prosper00/arpeggiator/20201117_184952.jpg

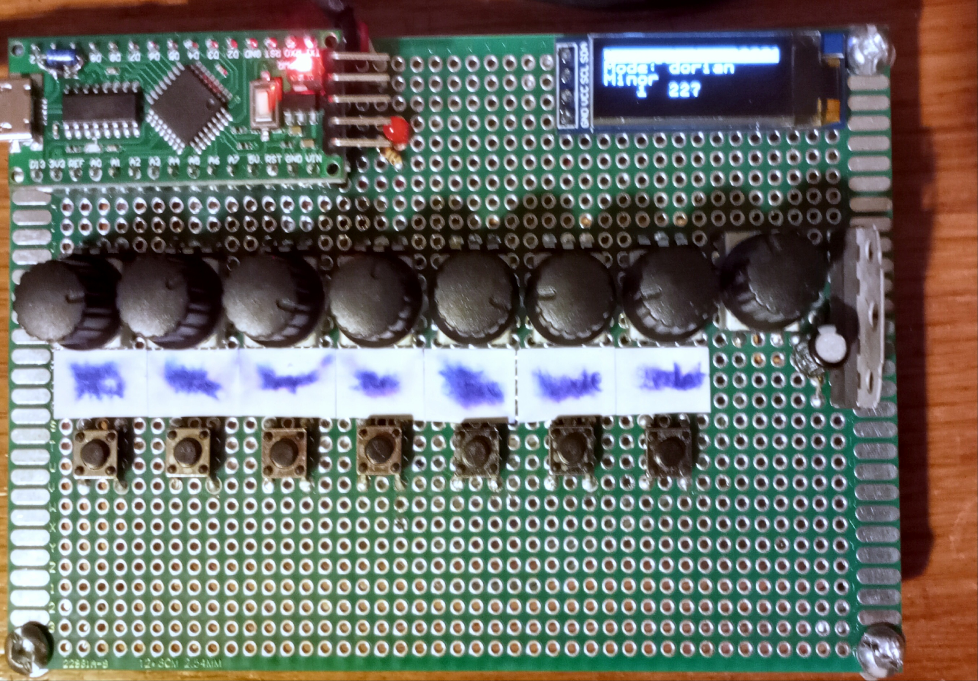
20201117_184952.jpg
