prosper00/arpeggiator/arpeggiator.pdf

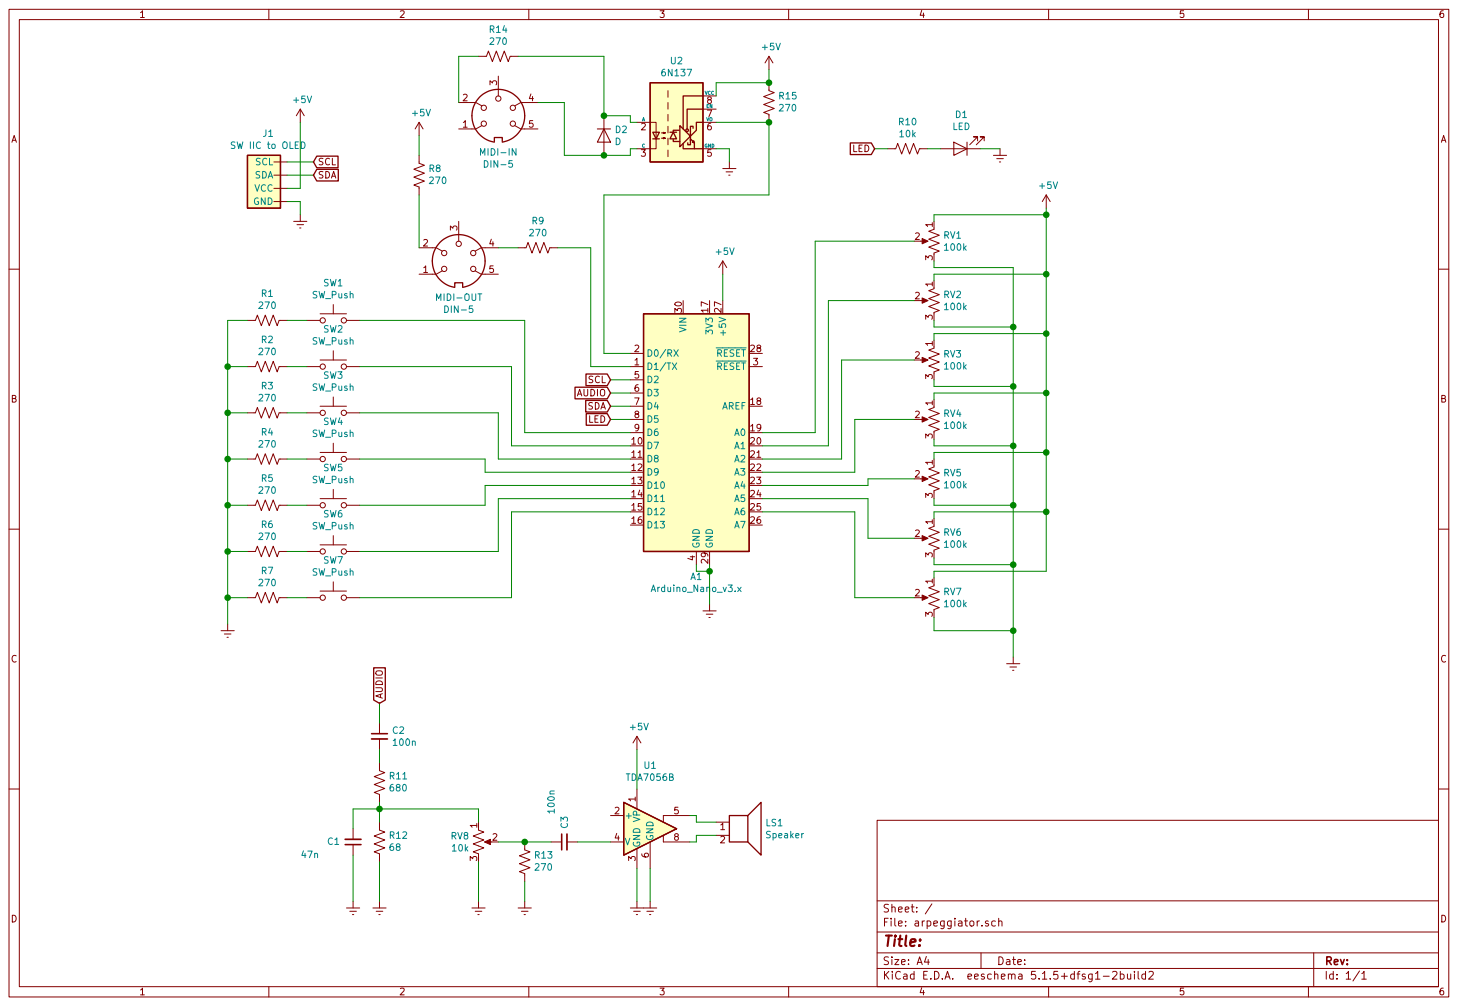
[picture p6: page 1]

File: arpeggiator.sch Sheet: /
