prosper00/arpeggiator/arpeggiator.sch

## KiCad design arpeggiator.sch (2020-11-18)

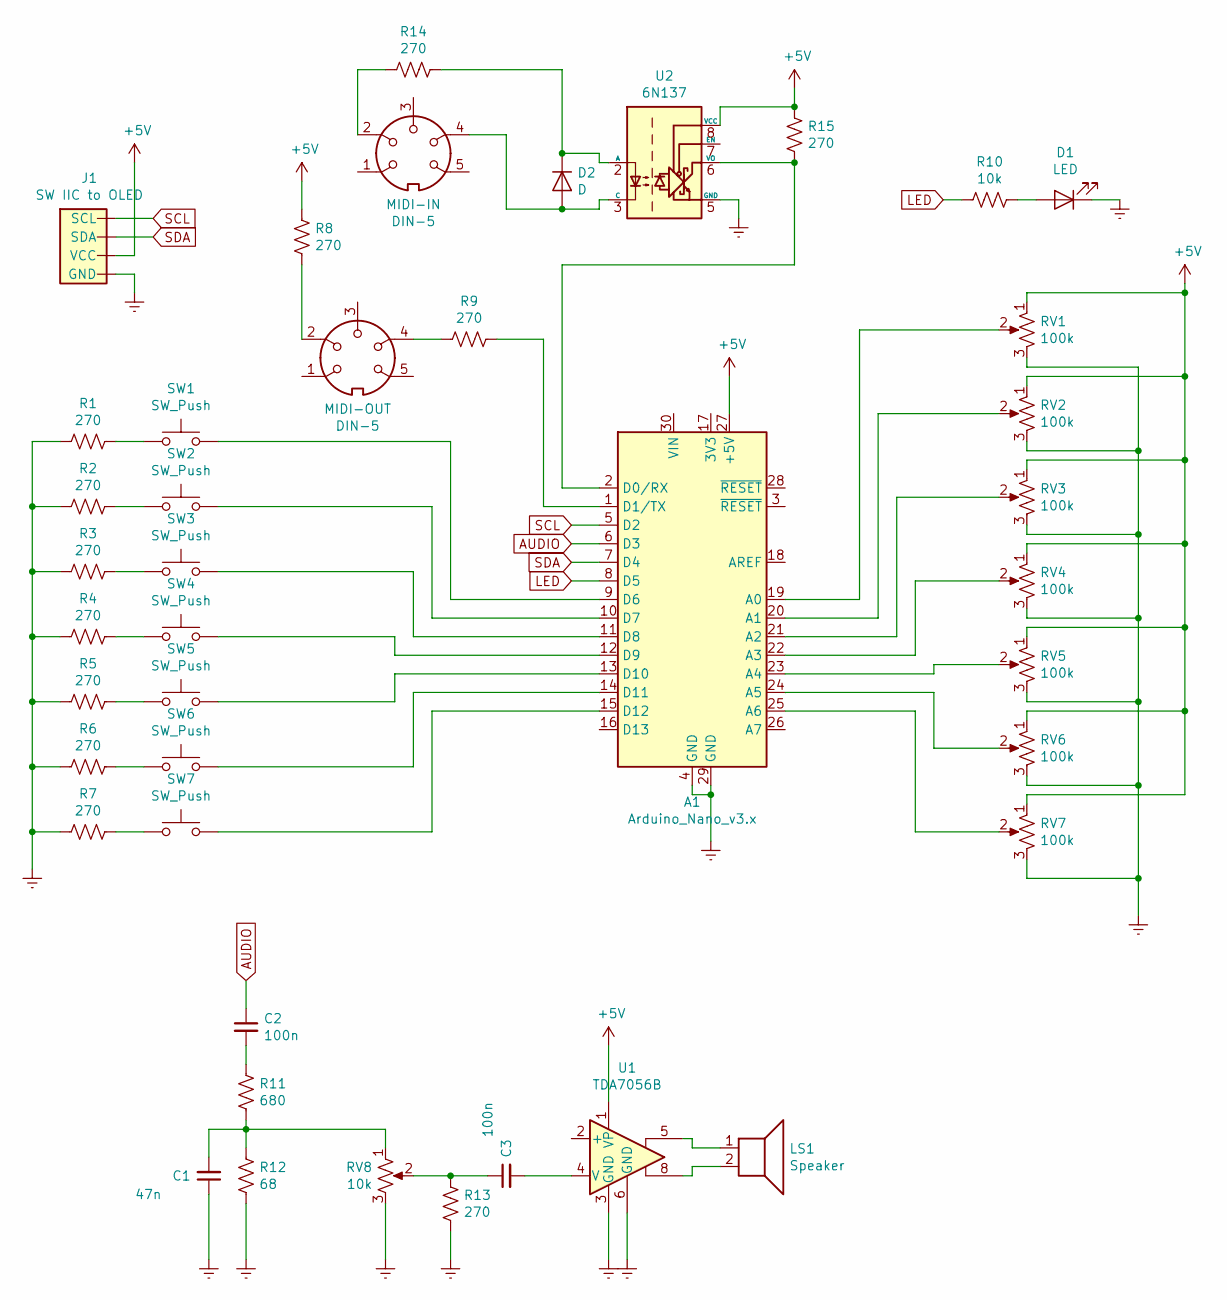
[picture p7: schematic arpeggiator.sch]

Parts:
A1: Arduino_Nano_v3.x; Arduino_Nano
C1: 47n
C2, C3: 100n
D1: LED
D2: D
J1: SW IIC to OLED; SPARKX_1X04_1MM_RA
LS1: Speaker
MIDI-IN: DIN-5
MIDI-OUT: DIN-5
R1, R2, R3, R4, R5, R6, R7, R8, R9, R13, R14, R15: 270
R10: 10k
R11: 680
R12: 68
RV1, RV2, RV3, RV4, RV5, RV6, RV7: 100k
RV8: 10k
SW1, SW2, SW3, SW4, SW5, SW6, SW7: SW_Push
U1: TDA7056B
U2: 6N137; DIP-8_W7.62mm

Connections:
+5V: A1.27 (+5V), J1.2 (VCC), R8.2, R15.2, RV1.1, RV2.1, RV3.1, RV4.1, RV5.1, RV6.1, RV7.1, U1.1 (VP), U2.8 (VCC)
AUDIO: A1.6 (D3), C2.1
Earth: A1.4 (GND), A1.29 (GND), C1.1, D1.1 (K), J1.1 (GND), R1.2, R2.2, R3.2, R4.2, R5.2, R6.2, R7.2, R12.1, R13.1, RV1.3, RV2.3, RV3.3, RV4.3, RV5.3, RV6.3, RV7.3, RV8.3, U1.3 (GND), U1.6 (GND), U2.5 (GND)
LED: A1.8 (D5), R10.2
unnamed: A1.1 (D1/TX), R9.1
unnamed: A1.2 (D0/RX), R15.1, U2.6 (VO)
unnamed: A1.9 (D6), SW1.2
unnamed: A1.10 (D7), SW2.2
unnamed: A1.11 (D8), SW3.2
unnamed: A1.12 (D9), SW4.2
unnamed: A1.13 (D10), SW5.2
unnamed: A1.14 (D11), SW6.2
unnamed: A1.15 (D12), SW7.2
unnamed: A1.19 (A0), RV1.2
unnamed: A1.20 (A1), RV2.2
unnamed: A1.21 (A2), RV3.2
unnamed: A1.22 (A3), RV4.2
unnamed: A1.23 (A4), RV5.2
unnamed: A1.24 (A5), RV6.2
unnamed: A1.25 (A6), RV7.2
unnamed: C1.2, R11.1, R12.2, RV8.1
unnamed: C2.2, R11.2
unnamed: C3.1, R13.2, RV8.2
unnamed: C3.2, U1.4 (V)
unnamed: D1.2 (A), R10.1
unnamed: D2.1 (K), R14.1, U2.2 (A)
unnamed: D2.2 (A), MIDI-IN.4, U2.3 (C)
unnamed: LS1.1, U1.5
unnamed: LS1.2, U1.8
unnamed: MIDI-IN.2, R14.2
unnamed: MIDI-OUT.2, R8.1
unnamed: MIDI-OUT.4, R9.2
unnamed: R1.1, SW1.1
unnamed: R2.1, SW2.1
unnamed: R3.1, SW3.1
unnamed: R4.1, SW4.1
unnamed: R5.1, SW5.1
unnamed: R6.1, SW6.1
unnamed: R7.1, SW7.1
SCL: A1.5 (D2), J1.4 (SCL)
SDA: A1.7 (D4), J1.3 (SDA)
