prosper00/arpeggiator/(commit log)

2020-11-11 Added some debug distplays to the OLED. Starting to integrate NoodleSynth library. Cleaned up and centralized pin assignmnet and intialization
2020-11-12 working on removing dependence on timerone library. Compiles. Probably doesn't work yet, haven't tested
    [arpeggiator.h, arpeggiator.ino, engine.cpp, engine.h]
2020-11-13 Fixed ADC code
2020-11-14 ADC ISR tweaks
2020-11-17 minor bugfixes. Updated README.
    [arpeggiator.h, arpeggiator.ino, engine.cpp, engine.h]
2020-11-18 adding schematics
    [noname.sch]
2020-11-18 Broke it all. Need to troubleshoot \'nanosynth\' calls in engine.cpp
    [arpeggiator.h, arpeggiator.ino, engine.cpp, engine.h]
2020-11-20 Updates to readme, added schematic PNG
2020-11-24 More tweaks to ISRs, trying to eliminate synth glitches. Still borken
    [arpeggiator.ino, engine.cpp, engine.h]
